3dprintedspringsEWU2020/testingmachine/ewu.bmp

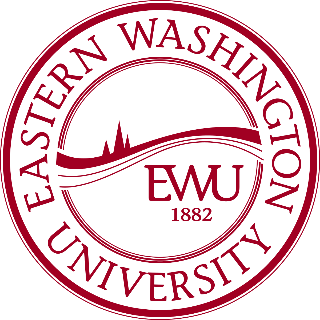
ewu.bmp
